muniza/kinematic_lute/images/base_dark.jpg

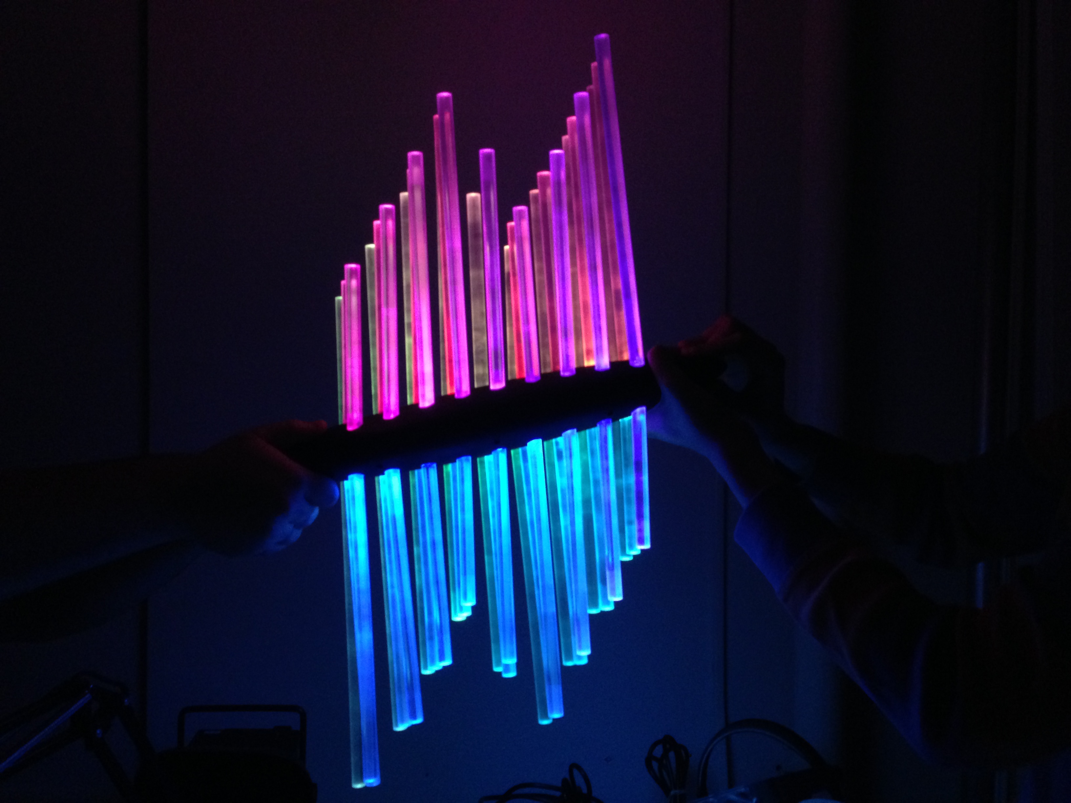
images/base_dark.jpg
