muniza/kinematic_lute/images/base_open.png

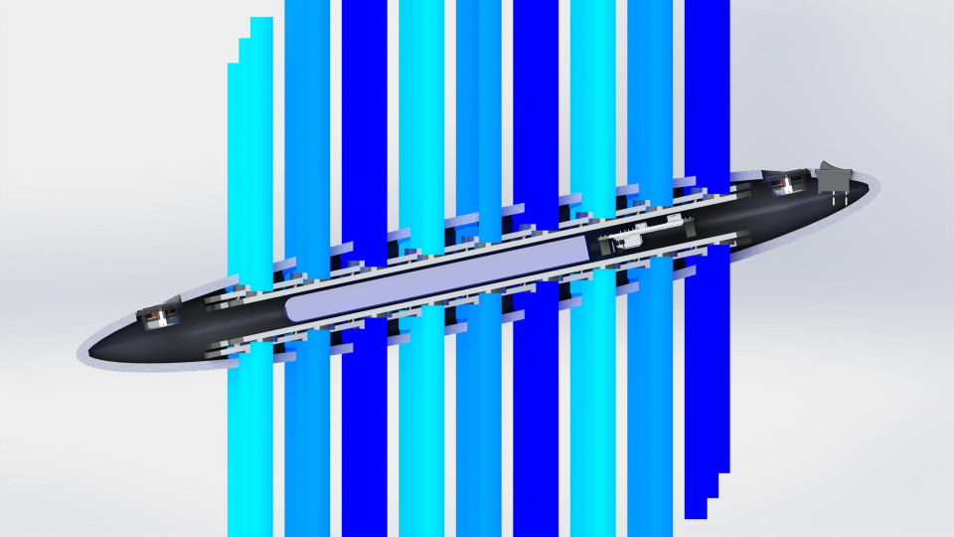
images/base_open.png
