muniza/kinematic_lute/README.md

kinematic_lute
==============

Project for Orpheus Myth Opera
* Root folder contains the files for the beaglebone black
* images contains the images used on the wiki
* lights contains the code for the neopixels
* mechanical contains the solidworks design files
* rx contains the base station atmega32u4 code
* schematics contains the schematics in eagle
* tx contains the remote atmega32u4 code

Full details can be found on the wiki
https://github.com/muniza/kinematic_lute/wiki
