muniza/kinematic_lute/images/base_architect.png

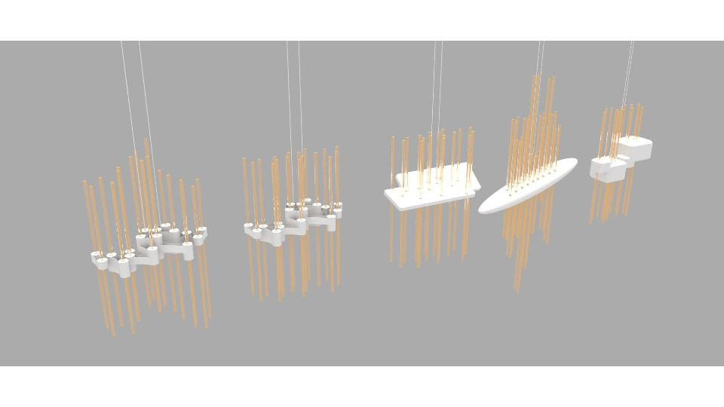
images/base_architect.png
