muniza/kinematic_lute/images/base_light.jpg

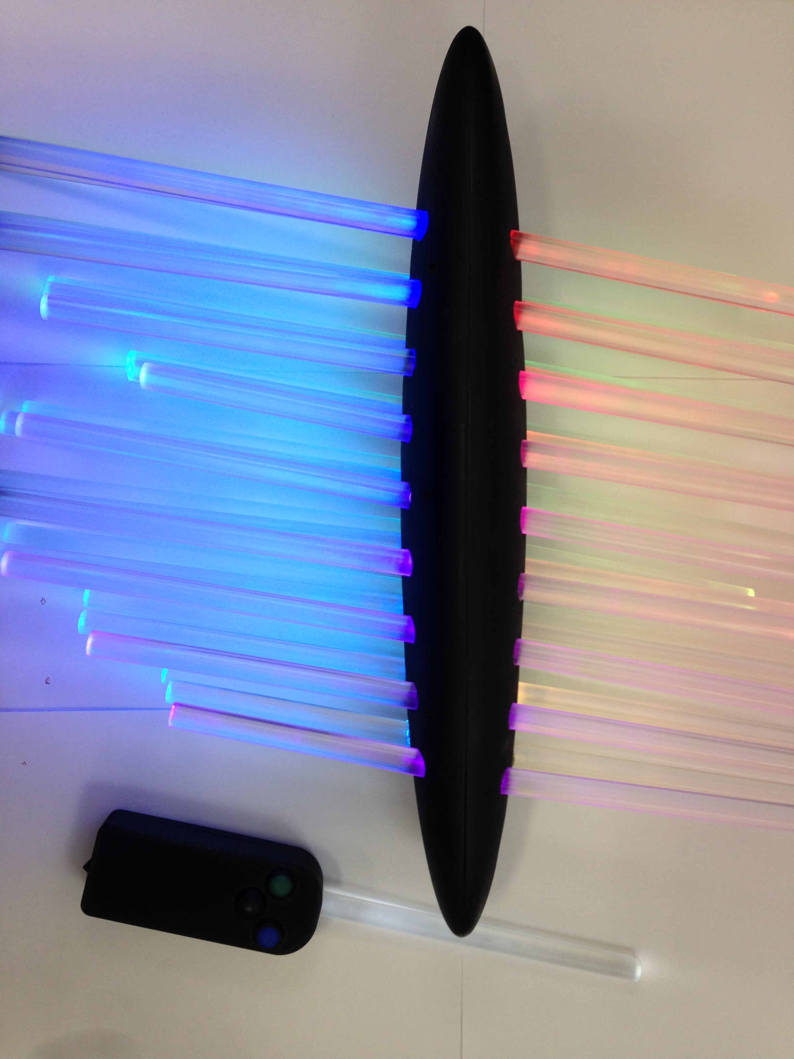
images/base_light.jpg
