muniza/kinematic_lute/images/base_schematic.png

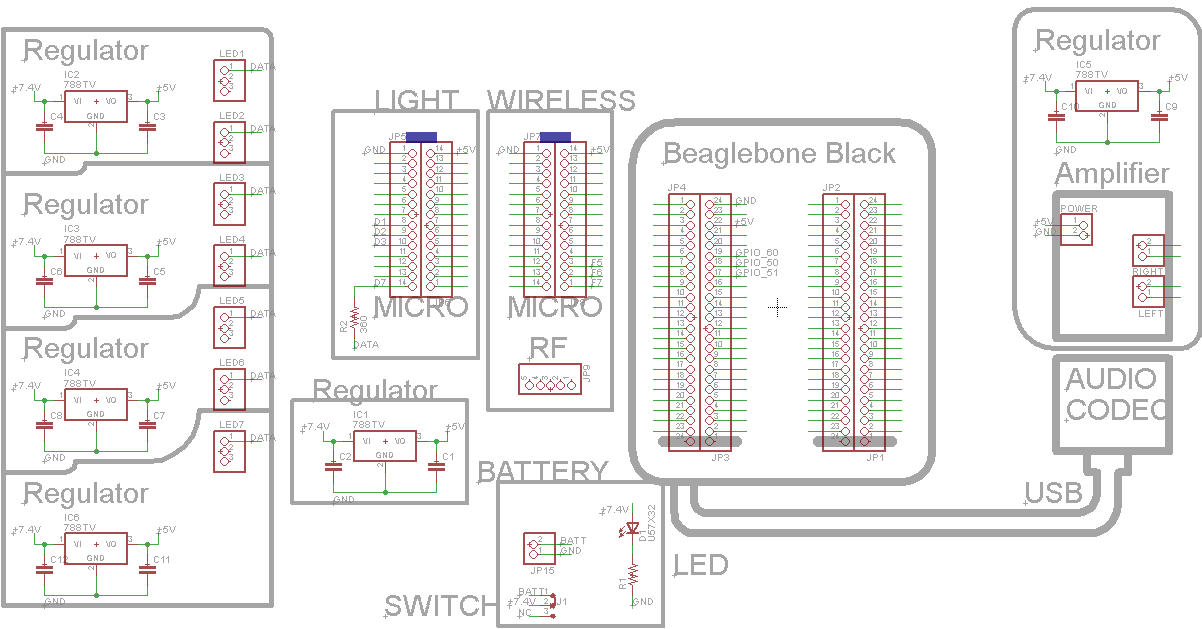
images/base_schematic.png
