muniza/kinematic_lute/images/base_side.png

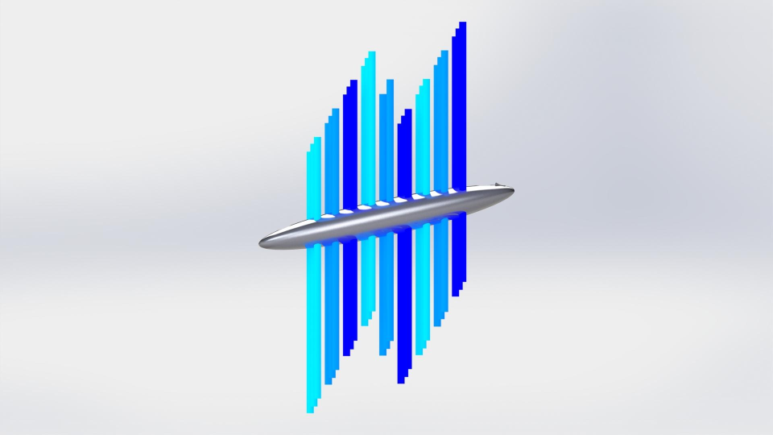
images/base_side.png
