muniza/kinematic_lute/images/base_start.png

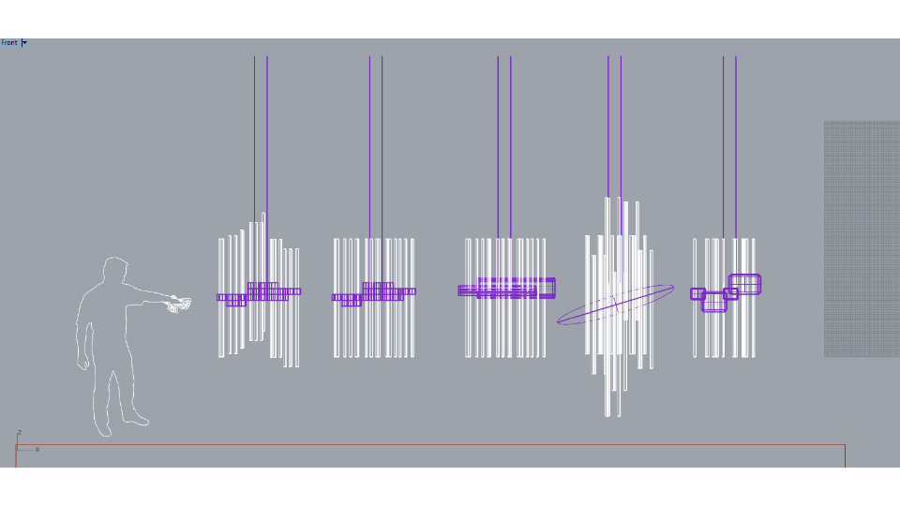
images/base_start.png
