muniza/kinematic_lute/images/base_top.png

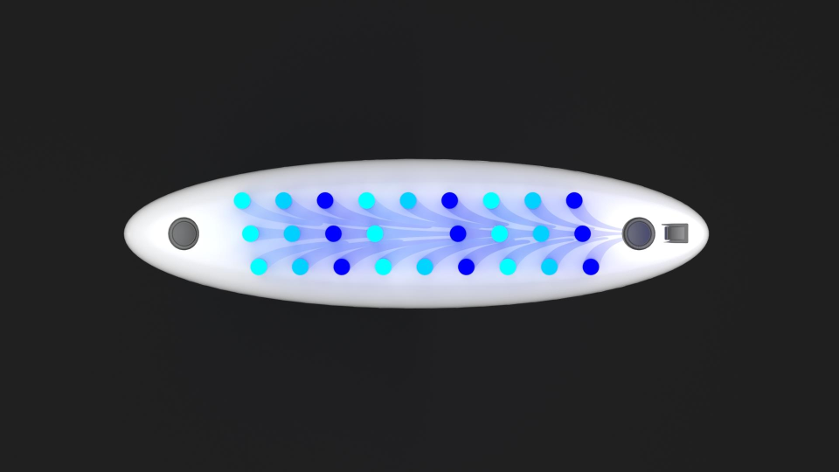
images/base_top.png
