muniza/kinematic_lute/images/remote_schematic.png

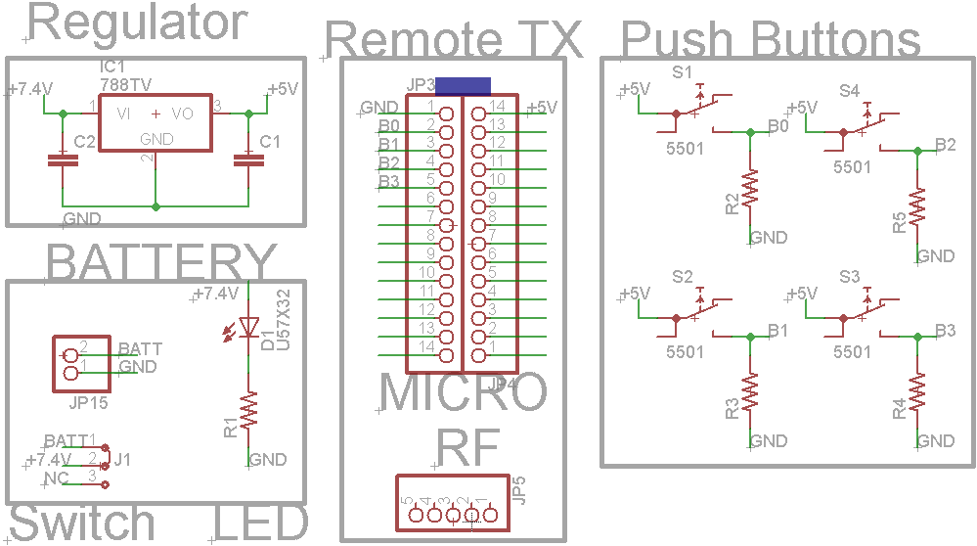
images/remote_schematic.png
