muniza/kinematic_lute/images/system.jpg

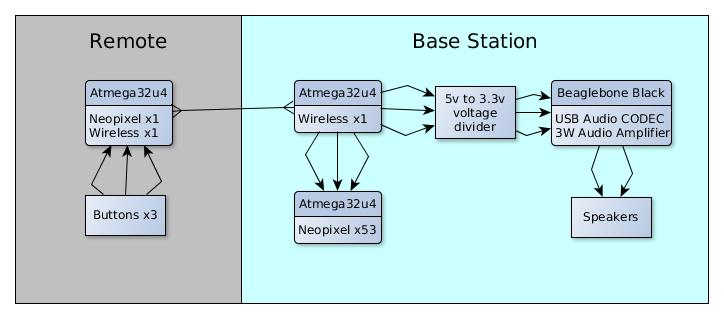
images/system.jpg
