muniza/kinematic_lute/schematics/base_station.sch

## EAGLE design schematics/base_station.sch (2014-12-18)

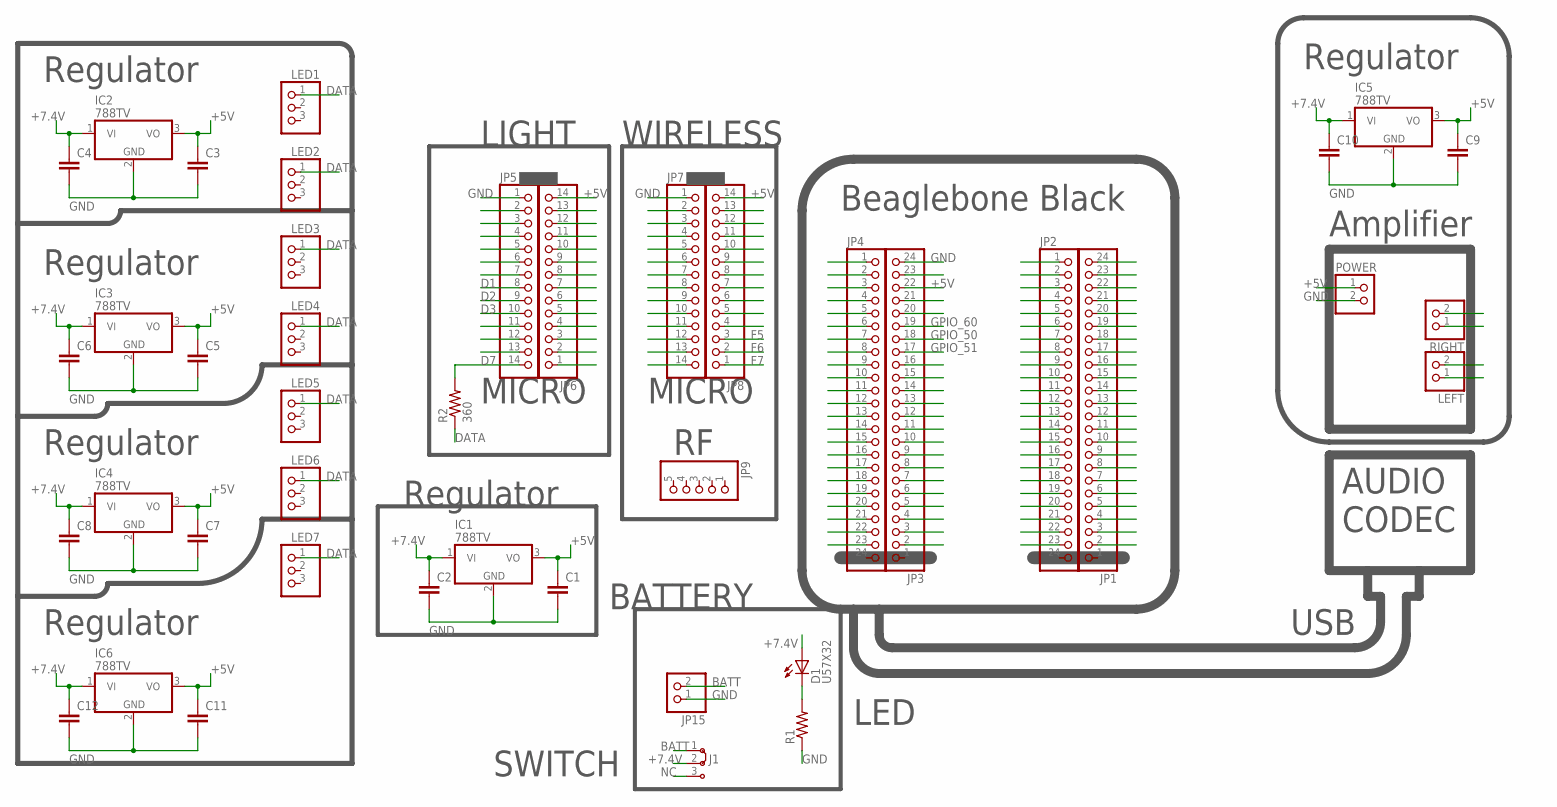
[picture p11: schematic base_station.sch]

Parts:
C1, C2, C3, C4, C5, C6, C7, C8, C9, C10, C11, C12: C2,5-3; C2.5-3
D1: U57X32
IC1, IC2, IC3, IC4, IC5, IC6: 788TV; TO220V
J1: J2X2MM; 04C
JP1, JP2, JP3, JP4: PINHD-1X24; 1X24
JP5, JP6, JP7, JP8: PINHD-1X14; 1X14
JP9: PINHD-1X5; 1X05
JP15: PINHD-1X2; 1X02
LED1, LED2, LED3, LED4, LED5, LED6, LED7: PINHD-1X3; 1X03
LEFT: PINHD-1X2; 1X02
POWER: PINHD-1X2; 1X02
R1: R-US_0204/2V; 0204V
R2: 360; 0204V
RIGHT: PINHD-1X2; 1X02

Connections:
+5V: C1.1, C3.1, C5.1, C7.1, C9.1, C11.1, IC1.3 (VO), IC2.3 (VO), IC3.3 (VO), IC4.3 (VO), IC5.3 (VO), IC6.3 (VO), JP3.22, JP6.14, JP8.14, POWER.1
+7.4V: C2.1, C4.1, C6.1, C8.1, C10.1, C12.1, D1.A, IC1.1 (VI), IC2.1 (VI), IC3.1 (VI), IC4.1 (VI), IC5.1 (VI), IC6.1 (VI), J1.2
BATT: J1.1, JP15.2
D0: JP5.7, JP7.7
D1: JP5.8, JP7.8
D2: JP5.9, JP7.9
D3: JP5.10
D7: JP5.14, R2.2
DATA: LED1.1, LED2.1, LED3.1, LED4.1, LED5.1, LED6.1, LED7.1, R2.1
F5: JP8.3
F6: JP8.2
F7: JP8.1
GND: C1.2, C2.2, C3.2, C4.2, C5.2, C6.2, C7.2, C8.2, C9.2, C10.2, C11.2, C12.2, IC1.2 (GND), IC2.2 (GND), IC3.2 (GND), IC4.2 (GND), IC5.2 (GND), IC6.2 (GND), JP3.24, JP5.1, JP7.1, JP15.1, POWER.2, R1.1
GPIO_50: JP3.18
GPIO_51: JP3.17
GPIO_60: JP3.19
unnamed: D1.K (C), R1.2
NC: J1.3

Notes on the sheet:
MICRO
Regulator
BATTERY
USB
AUDIO
Amplifier
Beaglebone Black
CODEC
SWITCH
LED
LIGHT
WIRELESS
