muniza/kinematic_lute/schematics/remote.sch

## EAGLE design schematics/remote.sch (2014-12-18)

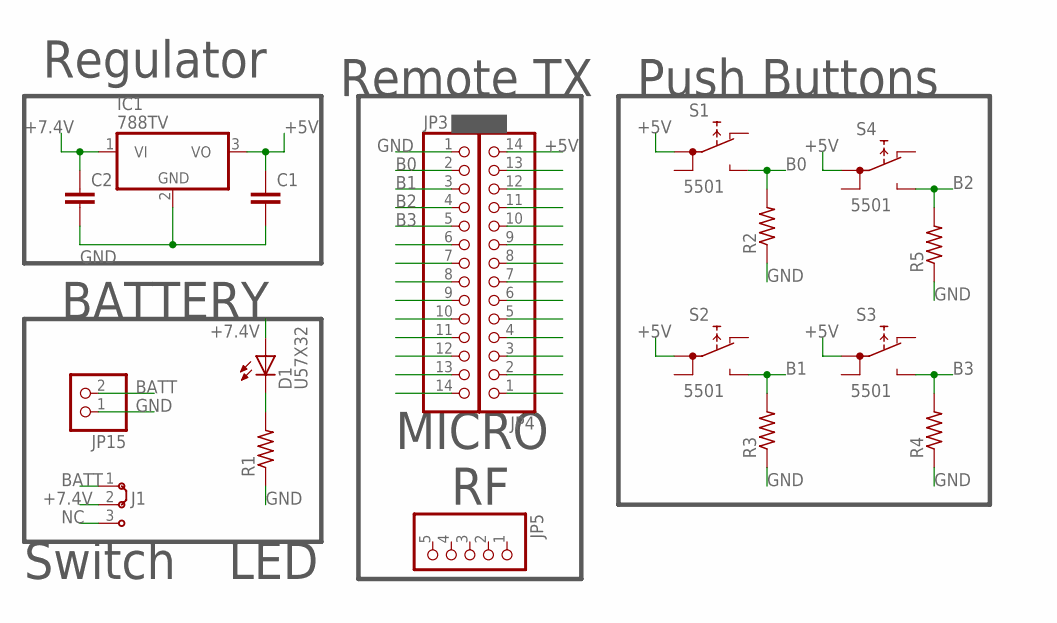
[picture p12: schematic remote.sch]

Parts:
C1, C2: C2,5-3; C2.5-3
D1: U57X32
IC1: 788TV; TO220V
J1: J2X2MM; 04C
JP3, JP4: PINHD-1X14; 1X14
JP5: PINHD-1X5; 1X05
JP15: PINHD-1X2; 1X02
R1, R2, R3, R4, R5: R-US_0204/2V; 0204V
S1, S2, S3, S4: 5501

Connections:
+5V: C1.1, IC1.3 (VO), JP4.14, S1.1A, S2.1A, S3.1A, S4.1A
+7.4V: C2.1, D1.A, IC1.1 (VI), J1.2
B0: JP3.2, R2.2, S1.NO
B1: JP3.3, R3.2, S2.NO
B2: JP3.4, R5.2, S4.NO
B3: JP3.5, R4.2, S3.NO
BATT: J1.1, JP15.2
D0: JP3.7
D1: JP3.8
D2: JP3.9
GND: C1.2, C2.2, IC1.2 (GND), JP3.1, JP15.1, R1.1, R2.1, R3.1, R4.1, R5.1
unnamed: D1.K (C), R1.2
NC: J1.3

Notes on the sheet:
MICRO
Regulator
BATTERY
Push Buttons
Switch
LED
Remote TX
