muniza/kinematic_lute/(commit log)

2014-12-18 added microcontroller wireless code and moved things around
2014-12-18 Added light show Arduino code
2014-12-18 added schematics
    [base_station.sch, remote.sch]
2014-12-18 Fixed light show code
    [lute_lightshow.ino]
2014-12-18 added boms
    [bom_base.csv, bom_remote.csv]
2014-12-18 fixed readme and added more parts to BOM
    [bom_base.csv]
